chotee/laser-pop/(list of files, cad)

Other CAD files:
cad/corn_holder_v3.scad
cad/penta_elements.scad
cad/corn_holder_v2.scad
