chotee/laser-pop/circuits/laser_sense.asc

C1: cap; 0.1µ
R1: res; 1k
R2: res; 1.5k
TSense: voltage; 2000m
U1: MCP6021
V1: voltage; 5
Named nets: 0, Vcc5
.tran 20m startup
