chotee/laser-pop/circuits/laser_supply_lt3086.asc

C1: polcap; 100µ; V=2 Irms=2.1 Rser=0.028 Lser=0 mfg="KEMET" pn="A700V107M002ATE028" type="Al electrolytic"
C2: cap; 100n
C3: cap; 10p
C4: cap; 10n
C5: cap; 10µ; V=25 Irms=0 Rser=0.001 Lser=0 mfg="TDK" pn="C575OX7RIE106M" type="X7R"
C6: cap; 22n
C7: cap; 10p
C8: cap; 10p
C9: cap; 10p
R1: res; 1µ
R2: res; 1k
R3: res; 1k
R4: res; 390
R5: res; 1k
R6: res; 10k; tol=1
R7: res; 10k; tol=1
R8: res; 4k7
R9: res; 10k
R10: res; 1µ
R11: res; 10k
R12: res; 1µ
R14: res; 1µ
R19: res; 1k
Rload: res; 3
U1: opamp2; LM324/NS
U2: opamp2; LM324/NS
U4: LT3086
U5: opamp2; LM324/NS
Vctl1: voltage; PWL(0 0 1m 5 9m 5 12m 0)
Vctl2: voltage; 12V
Vctl3: voltage; PULSE(0 5 0 0 0 26u 27u)
Vctl: voltage; 2.5
Vpwr: voltage; PWL(0 0 1m 5)
Named nets: 0, pwr, Vload, Vcc12, Vmon, Vset
.inc lm324.mod
.tran 10m
;;.step temp 25 125 10
