chotee/laser-pop/circuits/laser_supply_shunt.asc

C1: polcap; 4.7µ; V=25 Irms=24m Rser=5 Lser=0 mfg="Nichicon" pn="UPR1E4R7MAH" type="Al electrolytic"
C2: polcap; 4.7µ; V=25 Irms=24m Rser=5 Lser=0 mfg="Nichicon" pn="UPR1E4R7MAH" type="Al electrolytic"
C3: cap; 10n; V=10 Irms=10.541 Rser=0.004 Lser=0
C4: cap; 0.1µ
Q1: npn; BC547B
R1: res; 1k; tol=1
R2: res; 47k; tol=1
R3: res; 1k; tol=1
R4: res; 68k; tol=1
R5: res; 1k
R6: res; 12K; tol=1 pwr=0.1
R7: res; 10k; tol=1
Rload: res; 2; tol=1 pwr=5
shunt: res; 0.1
U1: opamp2; LM324/NS
U2: LT3081
U3: opamp2; LM324/NS
U4: pot; R=5k; T=.68
Vctl: voltage; PULSE(0 5 0 0 0 63u 64u)
Vpwr: voltage; PULSE(0 7.5 0 1u 0 10 10)
Named nets: 0, pwr, Out, ctl, LMset
;tran 30m
.inc lm324.mod
.tran 20m startup
