chotee/laser-pop/eagle/Motor_board.brd

## EAGLE design eagle/Motor_board.brd (2014-09-24)

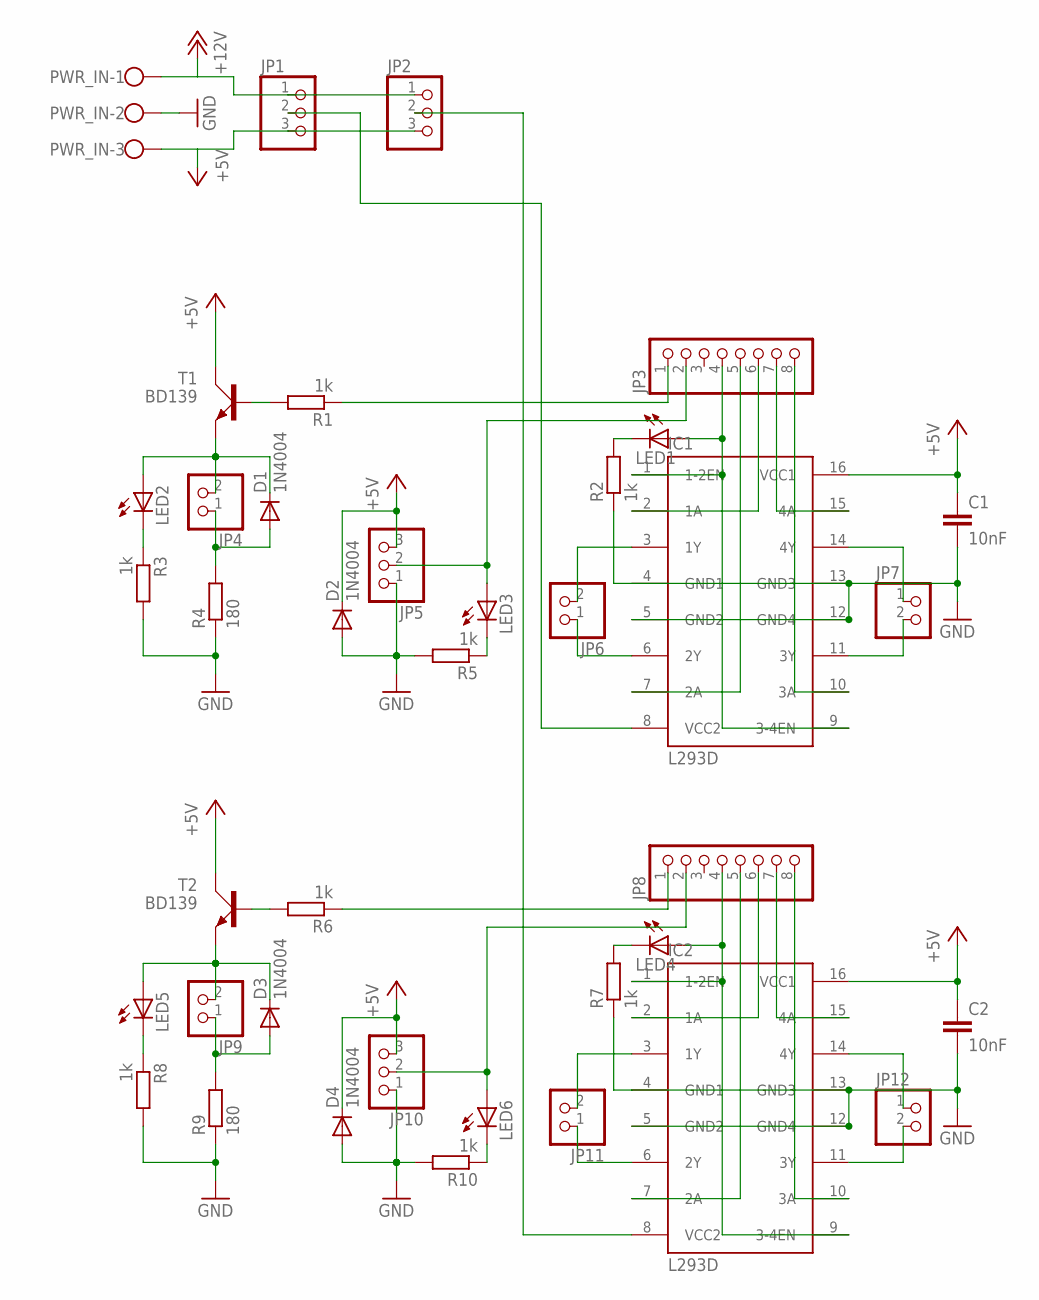
[picture p1: schematic Motor_board.sch]

Parts:
C1, C2: 10nF; C050-024X044
D1, D2, D3, D4: 1N4004; DO41-10
IC1, IC2: L293D; DIL16
JP1, JP2, JP5, JP10: PINHD-1X3; 1X03
JP3, JP8: PINHD-1X8; 1X08
JP4, JP6, JP7, JP9, JP11, JP12: PINHD-1X2; 1X02
LED1, LED2, LED3, LED4, LED5, LED6: LED3MM
PWR_IN: W237-103
R1, R2, R3, R5, R6, R7, R8, R10: 1k; 0207/7
R4, R9: 180; 0414V
T1, T2: BD139; TO126AV

Connections:
+5V: C1.1, C2.1, D2.C, D4.C, IC1.16 (VCC1), IC2.16 (VCC1), JP1.3, JP2.3, JP5.3, JP10.3, PWR_IN.3, T1.C, T2.C
+12V: JP1.1, JP2.1, PWR_IN.1
GND: C1.2, C2.2, D2.A, D4.A, IC1.4 (GND1), IC1.5 (GND2), IC1.12 (GND4), IC1.13 (GND3), IC2.4 (GND1), IC2.5 (GND2), IC2.12 (GND4), IC2.13 (GND3), JP5.1, JP10.1, PWR_IN.2, R2.1, R3.2, R4.1, R5.2, R7.1, R8.2, R9.1, R10.2
MTR_PWR1: IC1.8 (VCC2), JP1.2
MTR_PWR2: IC2.8 (VCC2), JP2.2
unnamed: IC2.1 (1-2EN), IC2.9 (3-4EN), JP8.4, LED4.A
unnamed: IC2.2 (1A), JP8.6
unnamed: IC2.7 (2A), JP8.5
unnamed: IC2.3 (1Y), JP11.2
unnamed: IC2.6 (2Y), JP11.1
unnamed: IC2.11 (3Y), JP12.2
unnamed: IC1.1 (1-2EN), IC1.9 (3-4EN), JP3.4, LED1.A
unnamed: IC1.10 (3A), JP3.8
unnamed: IC2.14 (4Y), JP12.1
unnamed: IC1.2 (1A), JP3.6
unnamed: IC1.7 (2A), JP3.5
unnamed: IC1.15 (4A), JP3.7
unnamed: IC2.10 (3A), JP8.8
unnamed: IC1.3 (1Y), JP6.2
unnamed: IC1.6 (2Y), JP6.1
unnamed: IC1.11 (3Y), JP7.2
unnamed: IC1.14 (4Y), JP7.1
unnamed: IC2.15 (4A), JP8.7
unnamed: R6.2, T2.B
unnamed: JP8.1, R6.1
unnamed: JP8.2, JP10.2, LED6.A
unnamed: D3.A, JP9.1, R9.2
unnamed: LED1.K (C), R2.2
unnamed: R1.2, T1.B
unnamed: JP3.1, R1.1
unnamed: D1.A, JP4.1, R4.2
unnamed: JP3.2, JP5.2, LED3.A
unnamed: D3.C, JP9.2, LED5.A, T2.E
unnamed: LED5.K (C), R8.1
unnamed: LED4.K (C), R7.2
unnamed: LED6.K (C), R10.1
unnamed: D1.C, JP4.2, LED2.A, T1.E
unnamed: LED2.K (C), R3.1
unnamed: LED3.K (C), R5.1

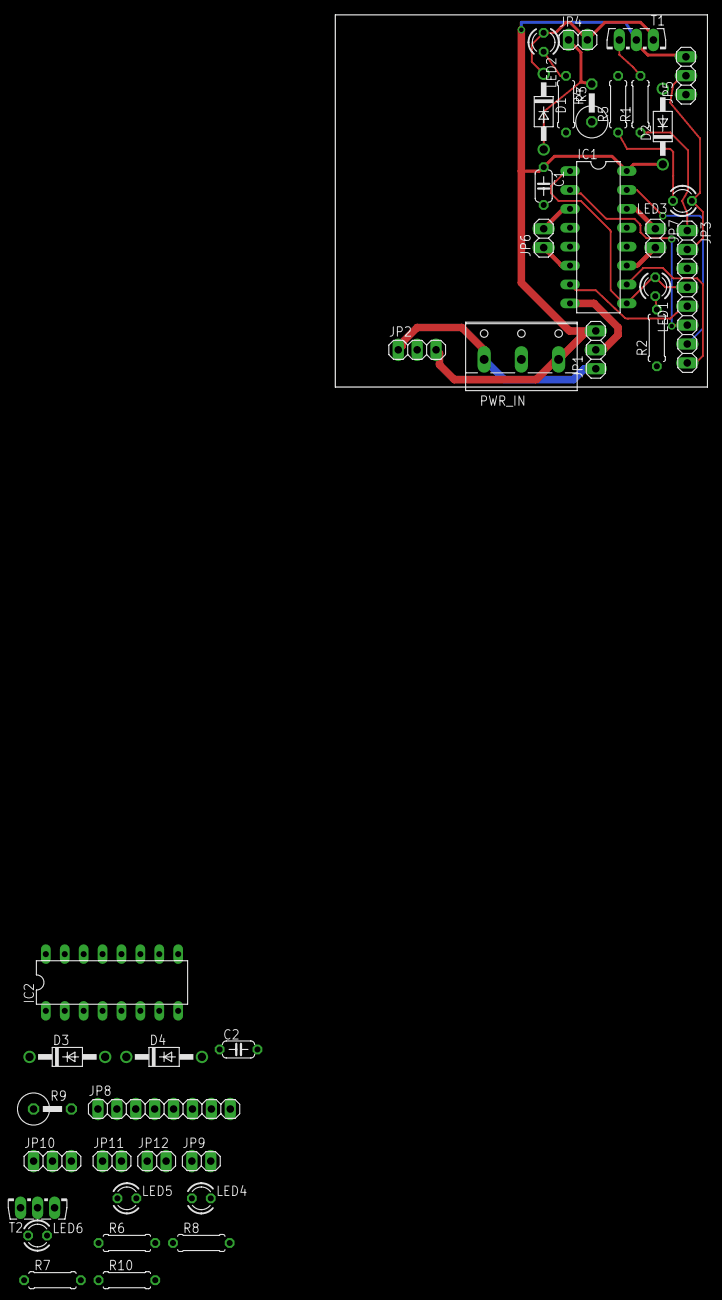
[picture p2: board Motor_board.brd from above]

Board: 2 copper layers, 50.0 x 50.0 mm, 39 parts (0 on the bottom side), 39 nets.
