chotee/laser-pop/eagle/board_lt3086.brd

## EAGLE design eagle/board_lt3086.brd (2014-09-24)

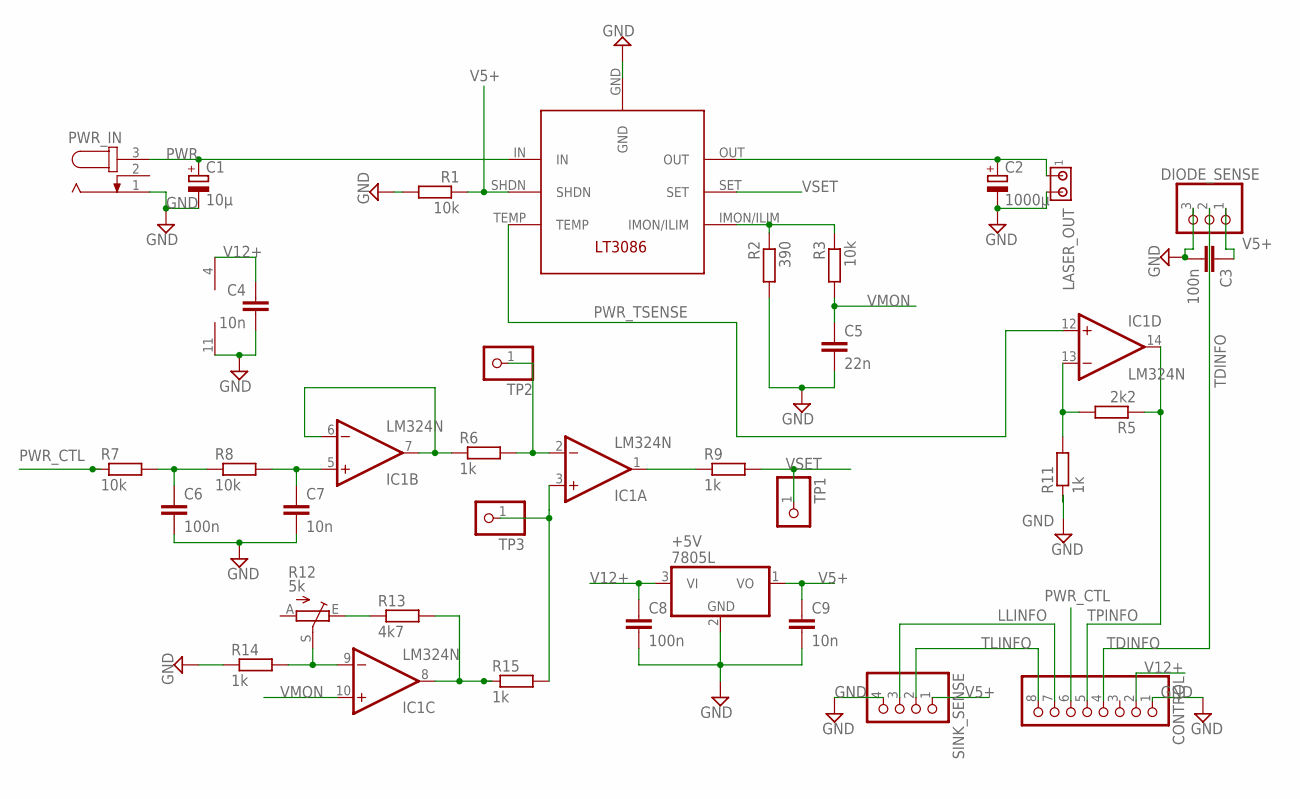
[picture p3: schematic board_lt3086.sch]

Parts:
+5V: 7805L; TO92
C1: 10µ; E2,5-7
C2: 1000µ; E3,5-10
C3, C6, C8: 100n; C050-035X075
C4, C7, C9: 10n; C050-024X044
C5: 22n; C050-024X044
CONTROL: PINHD-1X8; 1X08
DIODE_SENSE: PINHD-1X3; 1X03
IC1: LM324N; DIL14
LASER_OUT: 350428-1
PWR_CTRL: LT3086; LT3086-T7
PWR_IN: JACK-PLUG0; SPC4077
R1, R3, R7, R8: 10k; 0207/10
R2: 390; 0207/10
R5: 2k2; 0207/10
R6, R9, R11, R14, R15: 1k; 0207/10
R12: 5k; CA9V
R13: 4k7; 0207/10
SINK_SENSE: PINHD-1X4; 1X04
TP1, TP2, TP3: PINHD-1X1; 1X01

Connections:
GND: +5V.2 (GND), C1.-, C2.-, C3.2, C4.2, C5.2, C6.2, C7.2, C8.2, C9.2, CONTROL.1, DIODE_SENSE.3, IC1.11 (V-), LASER_OUT.2, PWR_CTRL.GND, PWR_IN.1, R1.2, R2.2, R11.1, R14.1, SINK_SENSE.4
LLINFO: CONTROL.7, SINK_SENSE.3
unnamed: IC1.6 (-IN), IC1.7 (OUT), R6.1
unnamed: C7.1, IC1.5 (+IN), R8.2
unnamed: C6.1, R7.2, R8.1
unnamed: IC1.1 (OUT), R9.1
unnamed: IC1.13 (-IN), R5.2, R11.2
unnamed: IC1.2 (-IN), R6.2, TP2.1
unnamed: IC1.3 (+IN), R15.2, TP3.1
unnamed: IC1.8 (OUT), R13.2, R15.1
unnamed: R12.E, R13.1
unnamed: IC1.9 (-IN), R12.S, R14.2
unnamed: PWR_CTRL.IMON/ILIM, R2.1, R3.1
PWR: C1.+, PWR_CTRL.IN, PWR_IN.3
PWR_CTL: CONTROL.6, R7.1
PWR_TSENSE: IC1.12 (+IN), PWR_CTRL.TEMP
TDINFO: CONTROL.4, DIODE_SENSE.2
TLINFO: CONTROL.8, SINK_SENSE.2
TPINFO: CONTROL.5, IC1.14 (OUT), R5.1
V5+: +5V.1 (VO), C3.1, C9.1, DIODE_SENSE.1, PWR_CTRL.SHDN, R1.1, SINK_SENSE.1
V12+: +5V.3 (VI), C4.1, C8.1, CONTROL.2, IC1.4 (V+)
VMON: C5.1, IC1.10 (+IN), R3.2
VOUT: C2.+, LASER_OUT.1, PWR_CTRL.OUT
VSET: PWR_CTRL.SET, R9.2, TP1.1

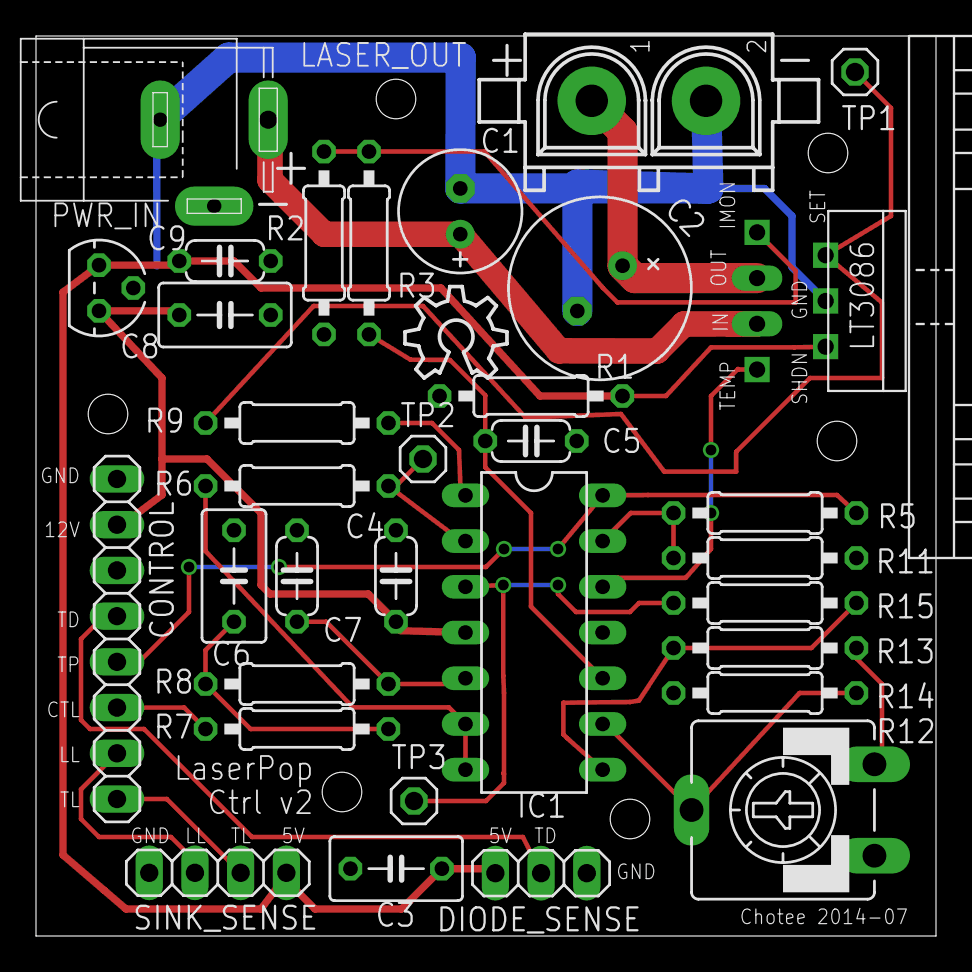
[picture p4: board board_lt3086.brd from above]

Board: 2 copper layers, 50.0 x 50.0 mm, 35 parts (0 on the bottom side), 24 nets.

Other parts of the board:
U$1: OSHW_8X200_NOTEXT
U$2: HEATSINK-11C/W
