chotee/laser-pop/eagle/IO_board.brd

## EAGLE design eagle/IO_board.brd (2014-09-24)

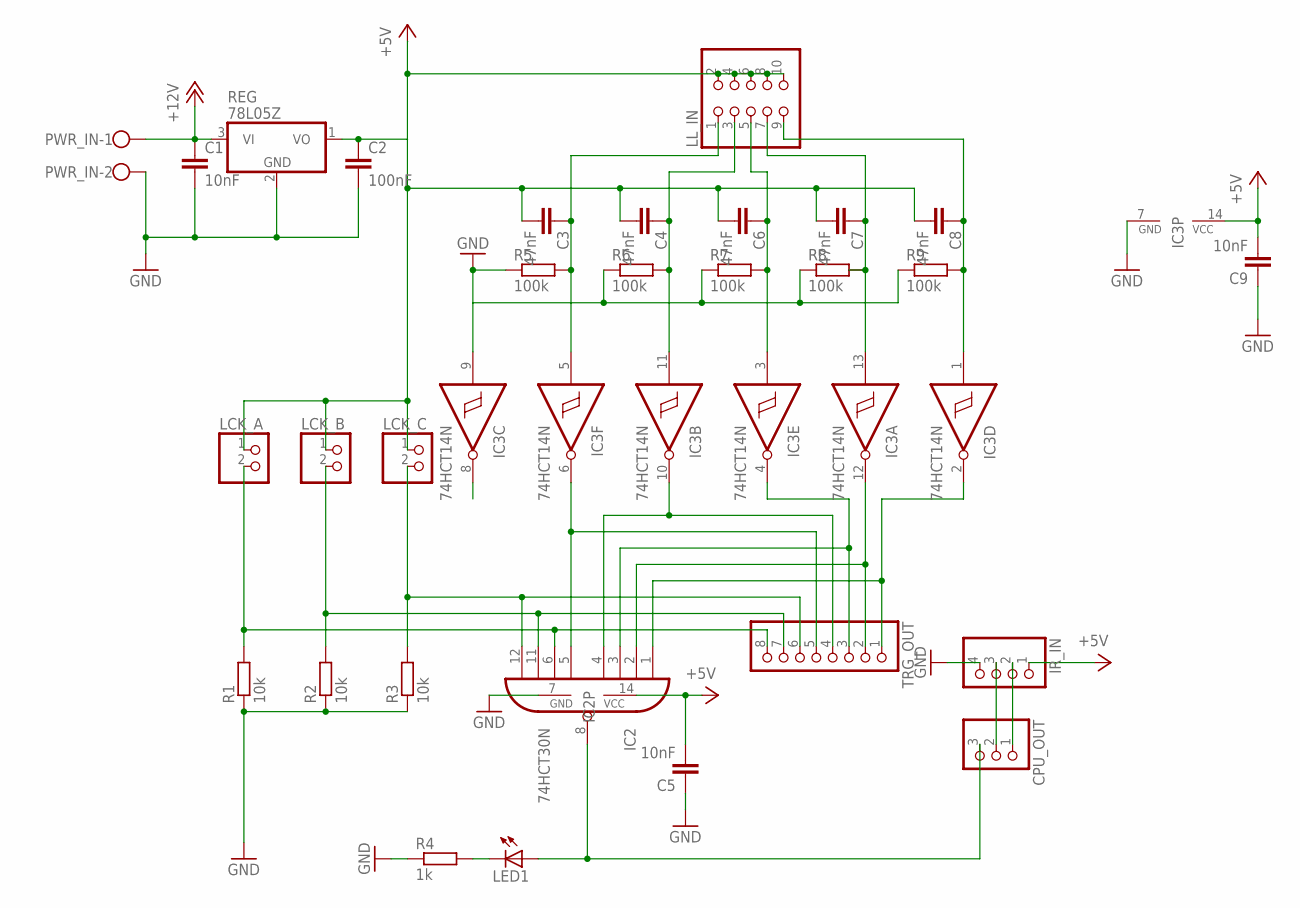
[picture p5: schematic IO_board.sch]

Parts:
C1: 10nF; C025-025X050
C2: 100nF; C025-025X050
C3, C4, C6, C7, C8: 47nF; C025-025X050
C5, C9: 10nF; C050-024X044
CPU_OUT: PINHD-1X3; 1X03
IC2: 74HCT30N; DIL14
IC3: 74HCT14N; DIL14
IR_IN: PINHD-1X4; 1X04
LCK_A: PINHD-1X2; 1X02
LCK_B: PINHD-1X2; 1X02
LCK_C: PINHD-1X2; 1X02
LED1: LED3MM
LL_IN: PINHD-2X5; 2X05
PWR_IN: W237-102
R1, R2, R3: 10k; 0207/7
R4: 1k; 0207/7
R5, R6, R7, R8, R9: 100k; 0207/7
REG: 78L05Z; TO92
TRG_OUT: PINHD-1X8; 1X08

Connections:
+5V: C2.1, C3.2, C4.2, C5.2, C6.2, C7.2, C8.2, C9.2, IC2.14 (VCC), IC3.14 (VCC), IR_IN.1, LCK_A.1, LCK_B.1, LCK_C.1, LL_IN.2, LL_IN.4, LL_IN.6, LL_IN.8, LL_IN.10, REG.1 (VO)
+12V: C1.1, PWR_IN.1, REG.3 (VI)
GND: C1.2, C2.2, C5.1, C9.1, IC2.7 (GND), IC3.7 (GND), IR_IN.4, PWR_IN.2, R1.1, R2.1, R3.1, R4.1, R5.1, R6.1, R7.1, R8.1, R9.1, REG.2 (GND)
unnamed: IC2.2 (I1), IC3.12 (O), TRG_OUT.2
unnamed: IC2.4 (I3), IC3.10 (O), TRG_OUT.4
unnamed: IC2.1 (I0), IC3.2 (O), TRG_OUT.1
unnamed: CPU_OUT.3, IC2.8 (O), LED1.A
unnamed: C4.1, IC3.11 (I), LL_IN.3, R6.2
unnamed: CPU_OUT.2, IR_IN.3
unnamed: C6.1, IC3.3 (I), LL_IN.5, R7.2
unnamed: C7.1, IC3.13 (I), LL_IN.7, R8.2
unnamed: C8.1, IC3.1 (I), LL_IN.9, R9.2
unnamed: CPU_OUT.1, IR_IN.2
unnamed: IC2.5 (I4), IC3.6 (O), TRG_OUT.5
unnamed: C3.1, IC3.5 (I), LL_IN.1, R5.2
unnamed: IC2.3 (I2), IC3.4 (O), TRG_OUT.3
unnamed: IC2.12 (I7), LCK_C.2, R3.2, TRG_OUT.6
unnamed: IC2.11 (I6), LCK_B.2, R2.2, TRG_OUT.7
unnamed: IC2.6 (I5), LCK_A.2, R1.2, TRG_OUT.8
unnamed: LED1.K (C), R4.2

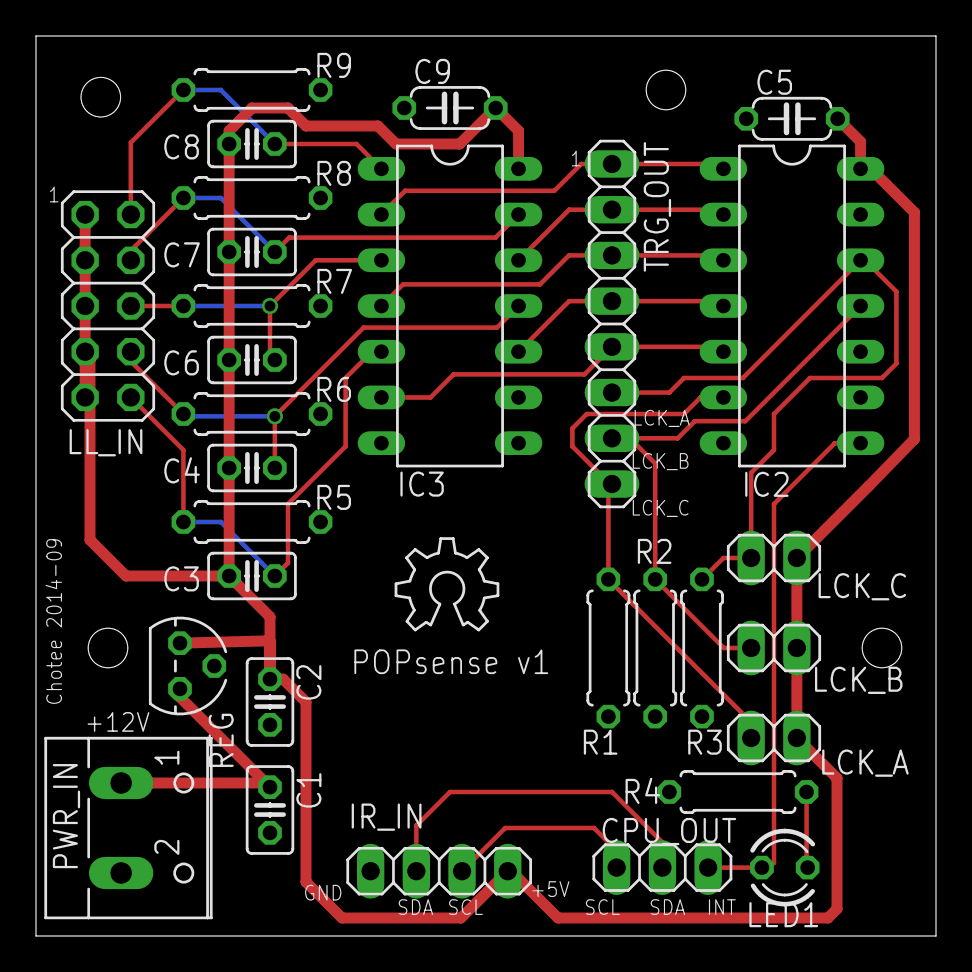
[picture p6: board IO_board.brd from above]

Board: 2 copper layers, 50.0 x 50.0 mm, 31 parts (0 on the bottom side), 20 nets.

Other parts of the board:
U$1: OSHW_6X200_NOTEXT
