chotee/laser-pop/(commit log)

2014-09-24 Initial Checkin
    [IO_board.brd, IO_board.sch, Motor_board.brd, Motor_board.sch, PSU_interface.sch, aimer.scad, board_lt3086.brd, board_lt3086.sch]
2014-09-24 Incorporating PID control for temperature regulation. Source: http://playground.arduino.cc/Code/PIDLibrary
2015-07-23 Restarting dome design effort. Added design for laser mount and lens.
    [basics.scad, centre_cover.scad, laser_elements.scad, penta_elements.scad]
2015-07-23 Dome is now existing.
    [centre_cover.scad, laser_elements.scad, penta_elements.scad]
2015-07-24 Initial multi-laser staggered setup.
    [centre_cover.scad, laser_elements.scad]
2015-07-26 changed colours.
    [centre_cover.scad]
2015-07-26 Added the bottom anti-dome.
    [centre_cover.scad]
2015-07-26 Fixed typo.
    [centre_cover.scad]
2015-07-26 added laser beam.
    [centre_cover.scad]
2015-07-26 State: Experimenting with handling of dome connections
    [centre_cover.scad]
2015-07-28 State: experimenting with proper definition of connectors.
    [centre_cover.scad]
